denkimono/alarm-clock/README.md

alarm-clock
===========

PIC source code for the alarm clock timer kit
