denkimono/alarm-clock/(commit log)

2017-01-15 added assembly and operating instructions
2019-09-18 added code and CAM files
    [drill_file.drl]
2019-09-18 added v1.1 resources
    [drill_file.drl]
